PaoloEstorm/MIDI-to-CV/Schematic_MIDI-TO-CV-ATTINY85_2026-01-09.pdf

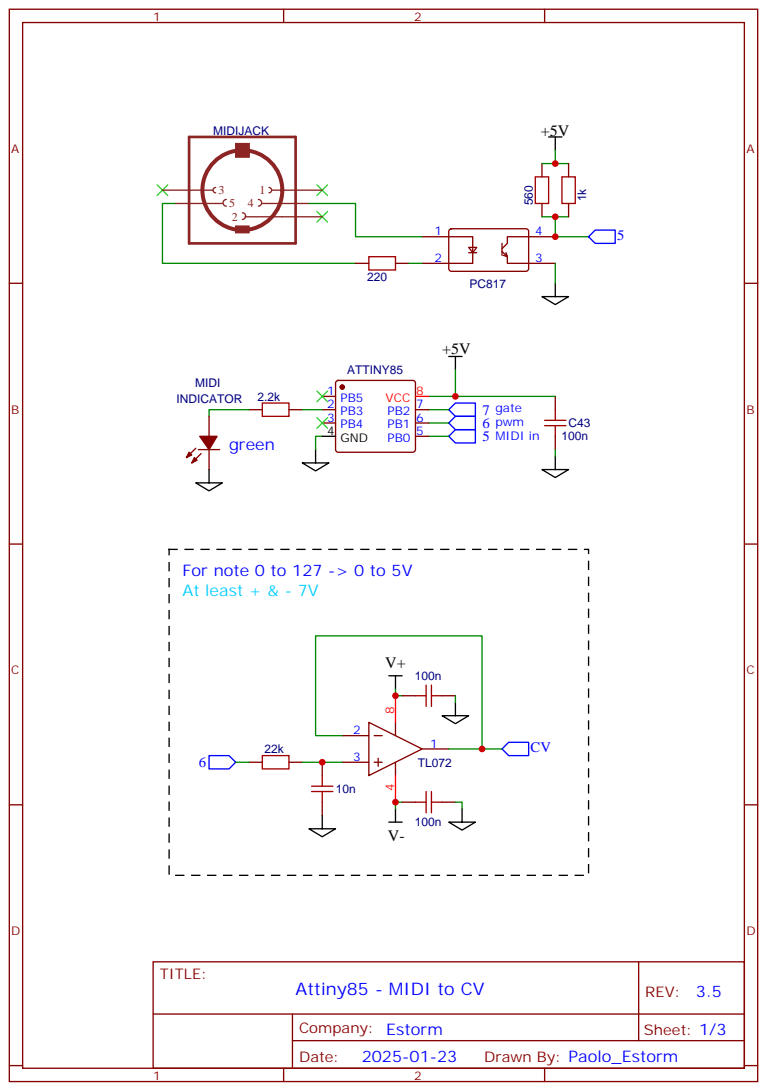
[picture p1: page 1]

For note 0 to 127 -> 0 to 5V
At least + & - 7V

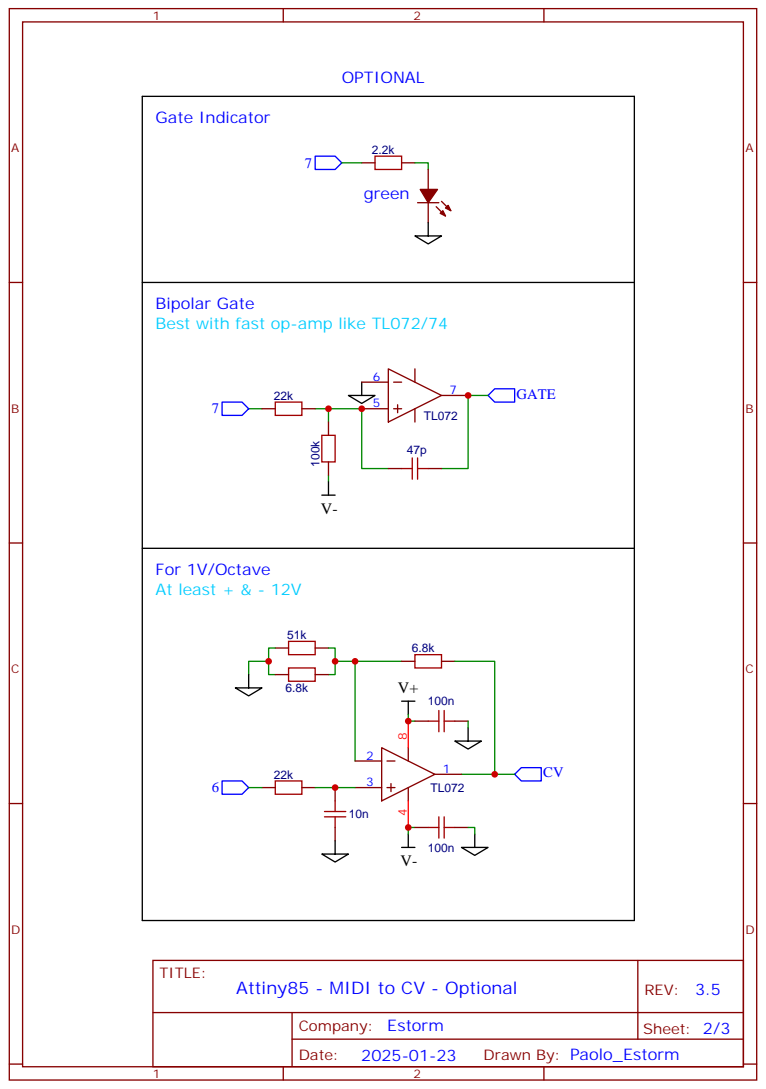
[picture p2: page 2]

Gate Indicator 2.2k 7 green

Bipolar Gate Best with fast op-amp like TL072/74 47p V-

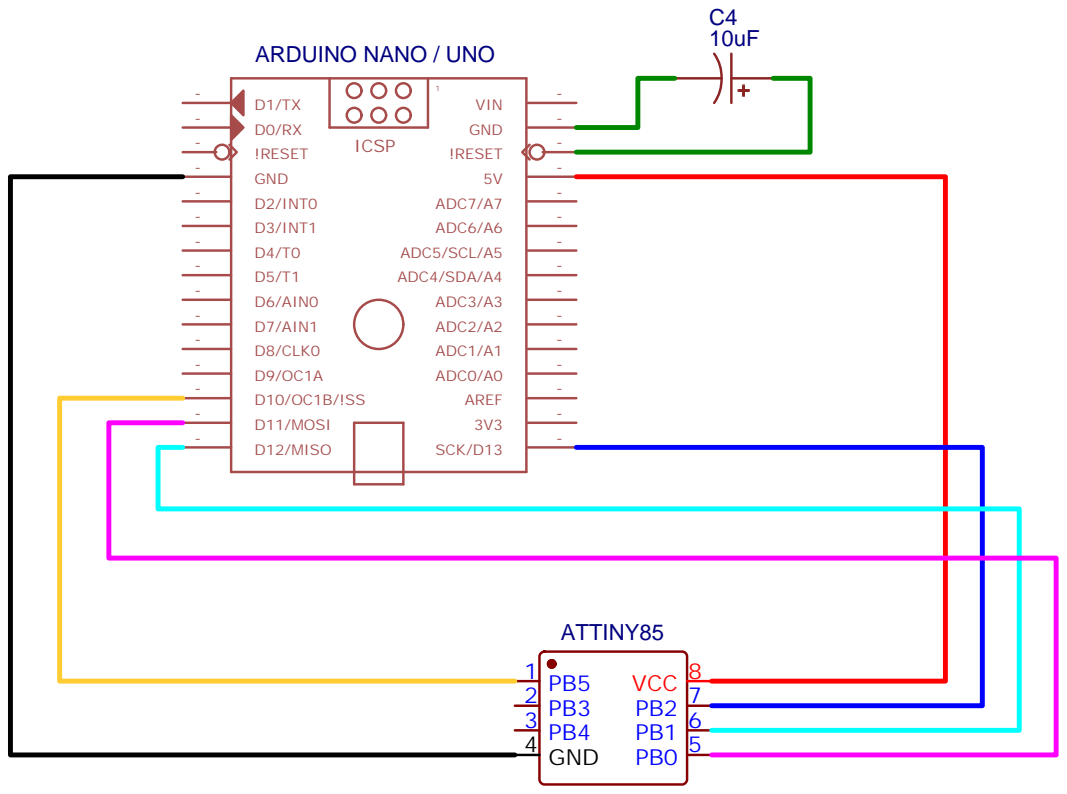
[picture p3: page 3]
